inassra/PCB_TravailleurIsole/Présentation travailleur isolé.pptx.pdf

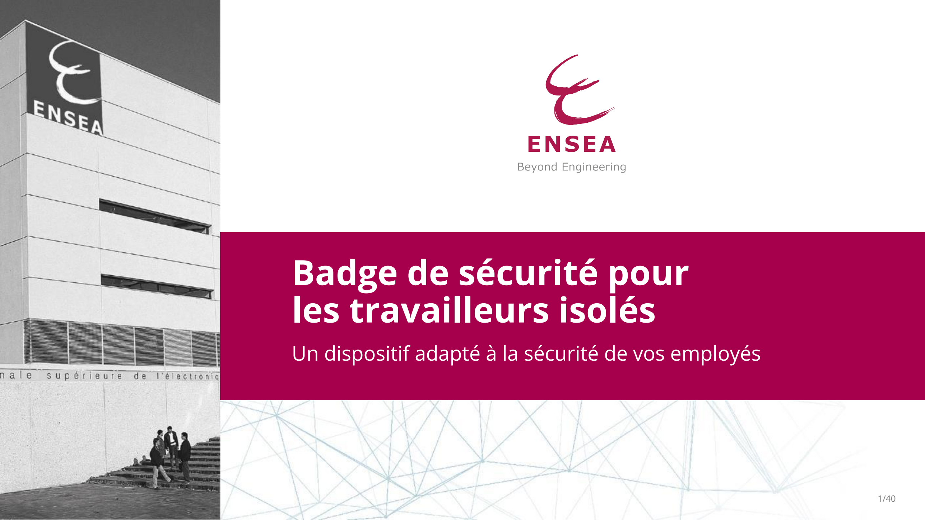
[picture p1: page 1]

# Badge de sécurité pour les travailleurs isolés

# Un dispositif adapté à la sécurité de vos employés

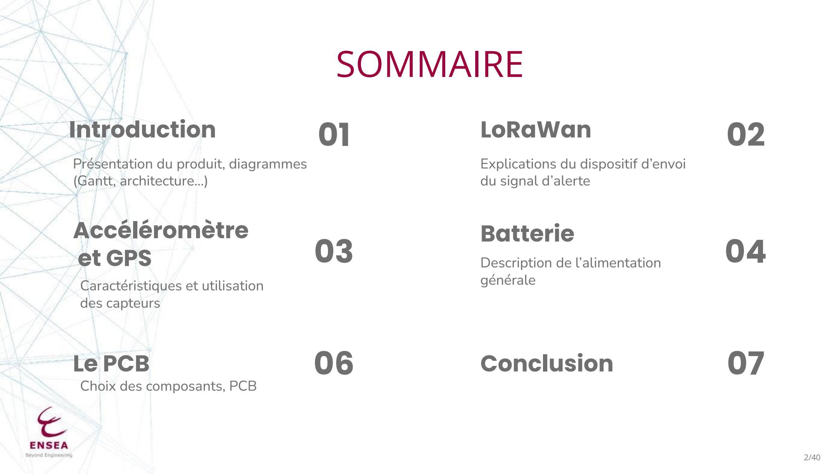
[picture p2: figure]
SOMMAIRE; Introduction; Présentation du produit, diagrammes (Gantt, architecture…); LoRaWan; Explications du dispositif d’envoi du signal d’alerte; Accéléromètre et GPS; Caractéristiques et utilisation des capteurs; Batterie; Description de l’alimentation générale; Le PCB; Choix des composants, PCB; Conclusion

# 01 Introduction

# Introduction 01

## ❖ En quoi consiste notre produit ?

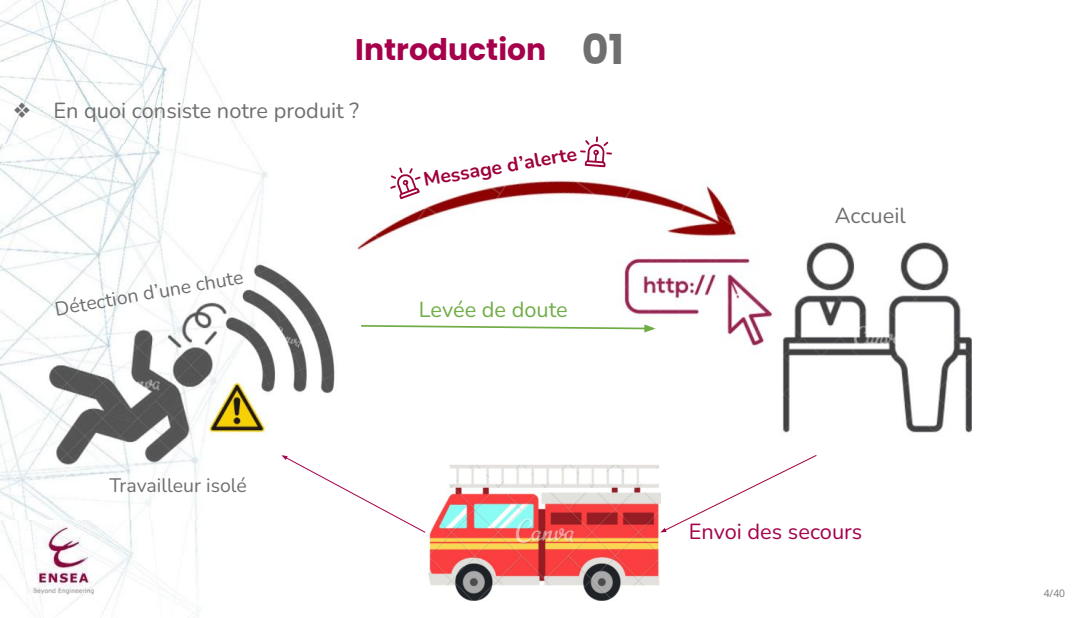
[picture p3: page 4]
Travailleur isolé; Accueil; Message d’alerte

Détection d’une chute

Levée de doute

Envoi des secours

# Introduction 01

## ❖ Le cahier des charges

Fonction | Sous-fonction | Critères | Niveaux
Localiser le travailleur (GPS) | | Précision | À 5 mètre près
| | Adapter au badge | Inférieur à feuille A5
| | Alimentation | 3,3V

Déterminer si le travailleur tombe
(Accéléromètre)
Mesurer l’accélération | Précision | 10 cm/s² mini suivant l’axe z
Mesurer la position | Précision | 5 cm mini suivant l’axe z

Détecter une pression sur

le bouton d’urgence | Durée pression | 3 s mini Bouton d’urgence

Détecter une pression sur
le bouton de fausse
urgence
| Alimentation | 3,3V
| Bonus « Haut parleur ou
LED» | 5/40

Fonction | Sous-fonction | Critères | Niveaux
Envoyer signal d’urgence (LoRaWan) | Envoyer signal à l’accueil Contenu Pas trop lourd (+ bonus « hôpital ») Localisation
Alimenter le système (Batterie) | | Autonomie | Entre 10h et 12h
| | Adapter au badge | Inférieur à feuille A5
| | Tension délivrée | 5V
| Se recharger | Temps de recharge | 3h mini
| | Doit résister à la recharge
Traitement de données (Carte STM32) | | Nombre d’entrées suffisantes
| | Recevoir les données
| | Envoyer signal au LoraWan | Si chute détectée

Rapidité

Alimentation | 5V

# Introduction 01

## ❖ Le cahier des charges

# Introduction 01

## ❖ Le diagramme d'architecture

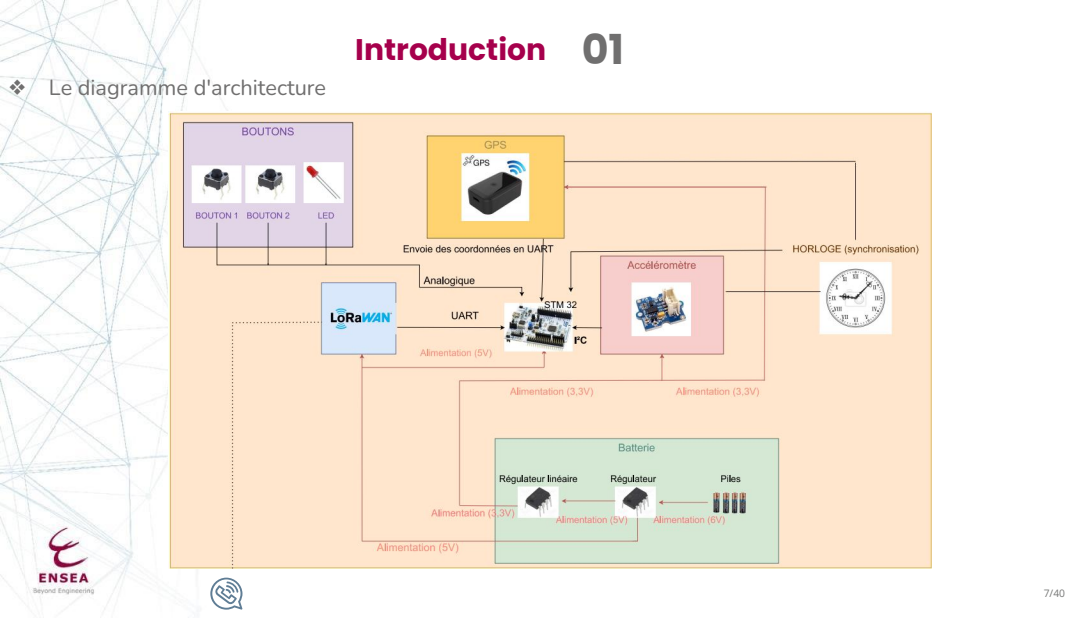
[picture p4: page 7]

# Introduction 01

## ❖ Le diagramme de Gantt

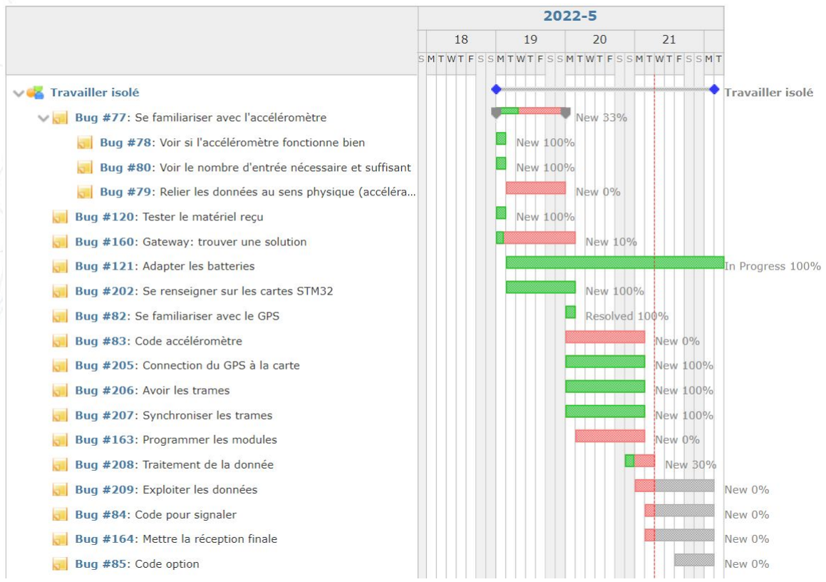
[picture p5: figure]

# 02 LoRaWan

## Qu’est-ce que LoRa ?

# LoRaWan 02

## ❖ LoRa ou LoRaWan ?

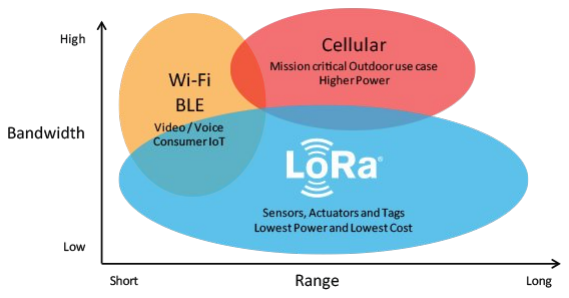
[picture p6: figure]
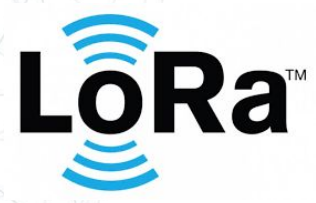
[picture p7: figure]

# LoRaWan 02

## ❖ LoRa ou LoRaWan ?

## Qu’est-ce que LoRaWAN ?

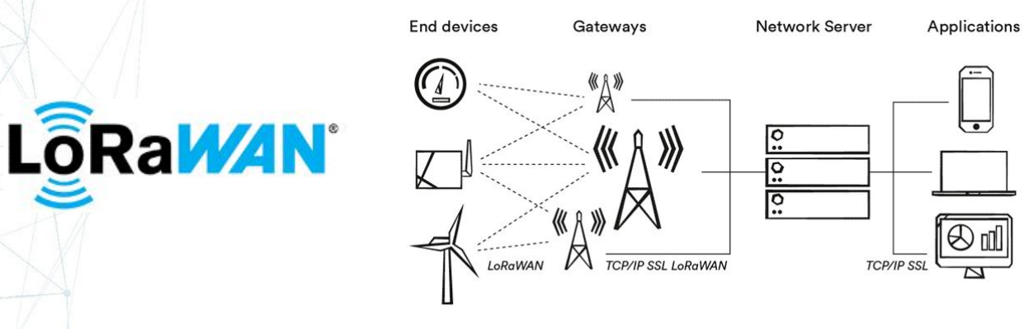
[picture p8: figure]

# LoRaWan 02

## ❖ Notre choix : pourquoi LoRa ?

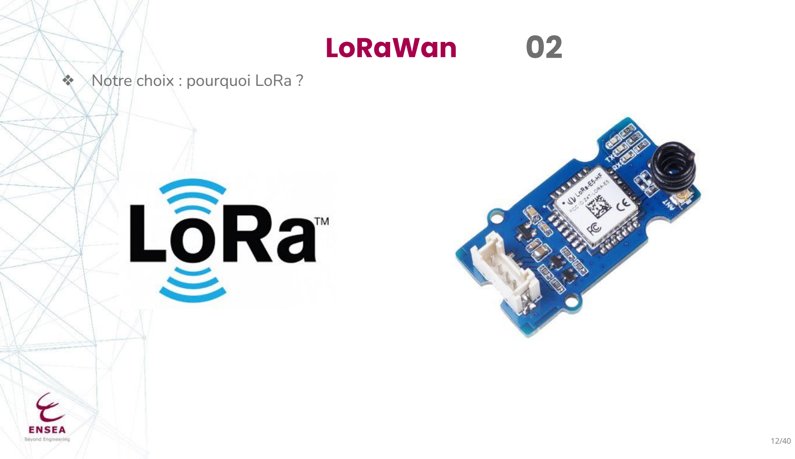
[picture p9: page 12]

# LoRaWan 02

## ❖ Le module

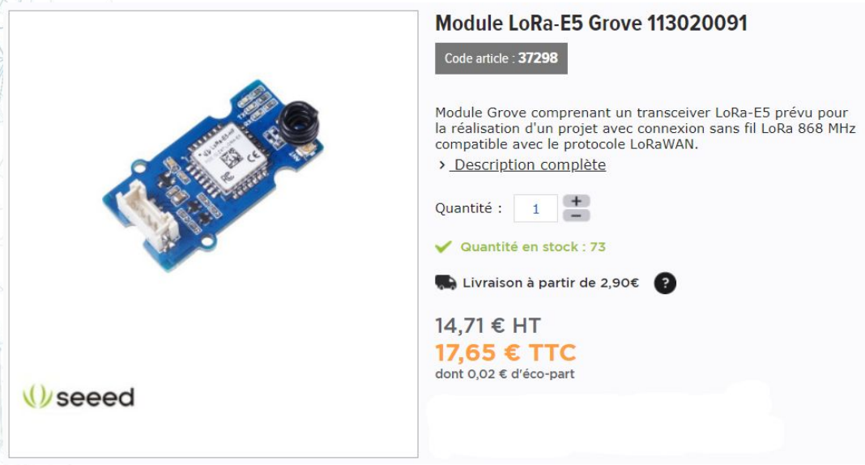
[picture p10: figure]

# LoRaWan 02

## ❖ Comment cela fonctionne-t-il ?

## P2P connection:

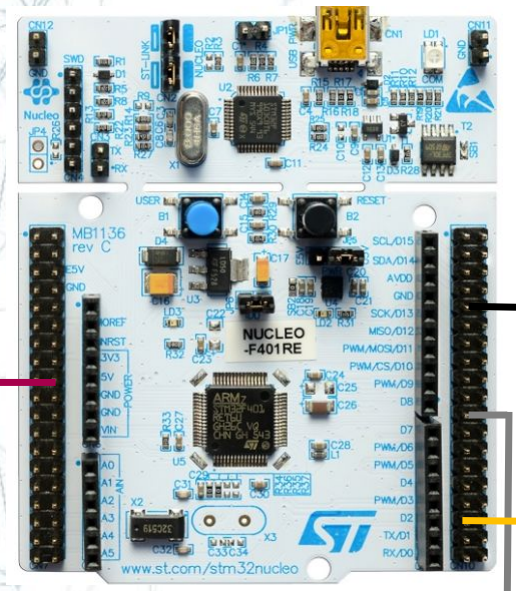
[picture p11: figure]
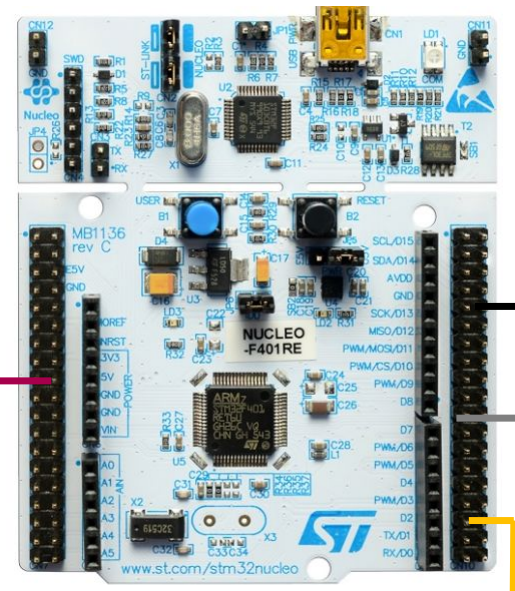
[picture p12: figure]

# LoRa

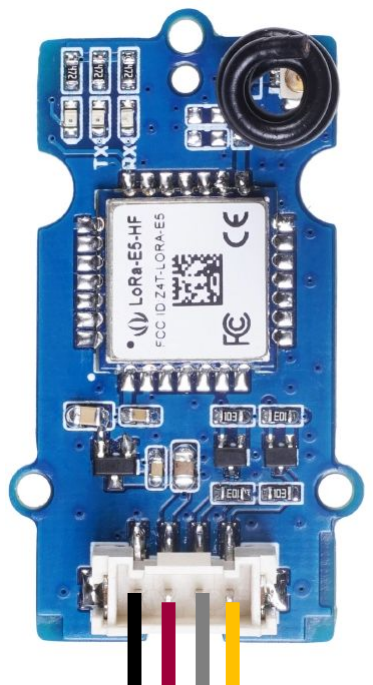
[picture p13: figure]
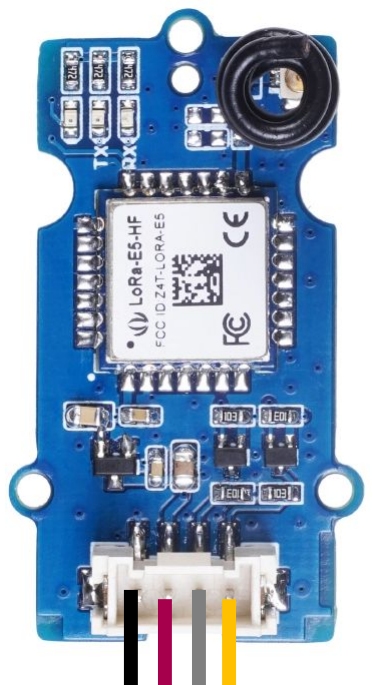
[picture p14: figure]

UART | UART

# LoRaWan 02

## ❖ Notre montage

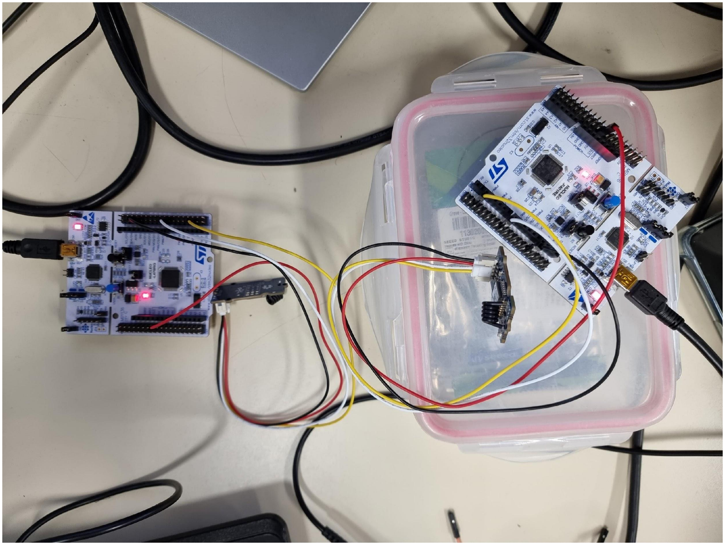
[picture p15: figure]

# 03 Accéléromètre et GPS

# Accéléromètre et GPS 03

## ❖ L’accéléromètre

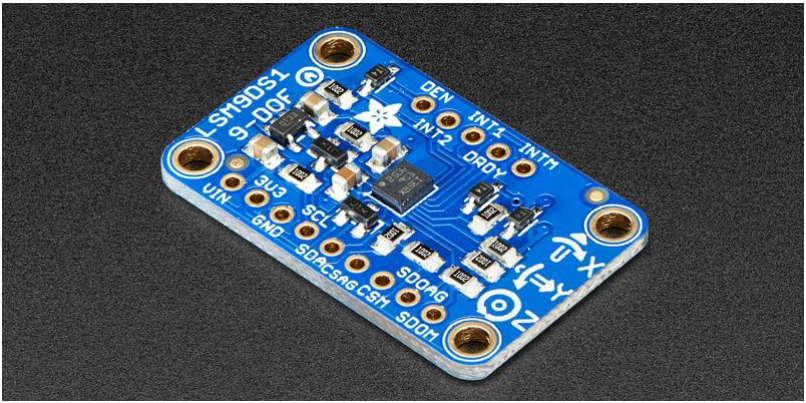
[picture p16: figure]

Adafruit LSM9DS1

# Accéléromètre et GPS 03

## ❖ L’accéléromètre : Analyse SWOT

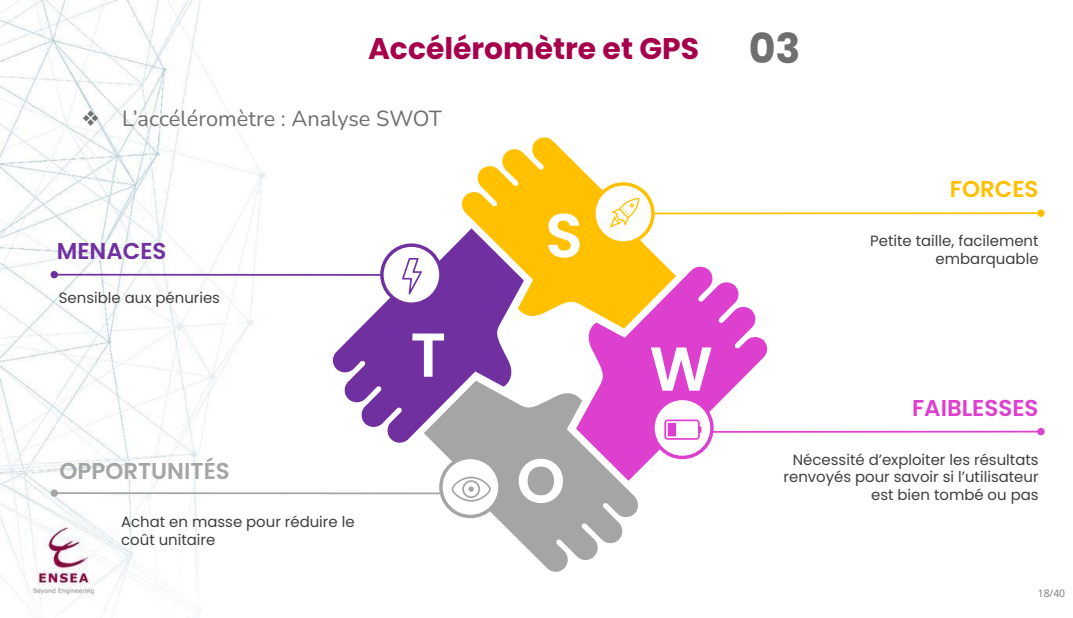
[picture p17: page 18]
embarquable; FORCES; FAIBLESSES; MENACES; OPPORTUNITÉS

Petite taille, facilement

Sensible aux pénuries

Nécessité d’exploiter les résultats
renvoyés pour savoir si l’utilisateur

est bien tombé ou pas

Achat en masse pour réduire le
coût unitaire

# Accéléromètre et GPS 03

## ❖ L’accéléromètre : le câblage

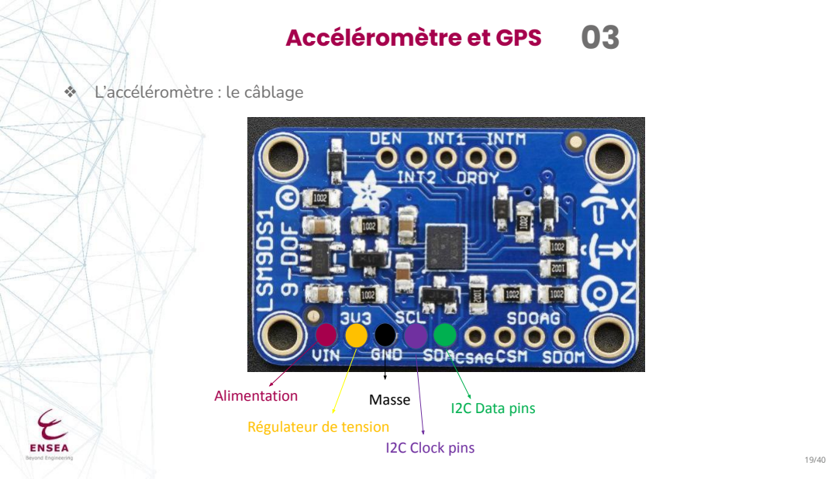
[picture p18: page 19]
Alimentation; Masse; I2C Clock pins; I2C Data pins

Régulateur de tension

# Accéléromètre et GPS 03

## ❖ L’accéléromètre : mode de fonctionnement

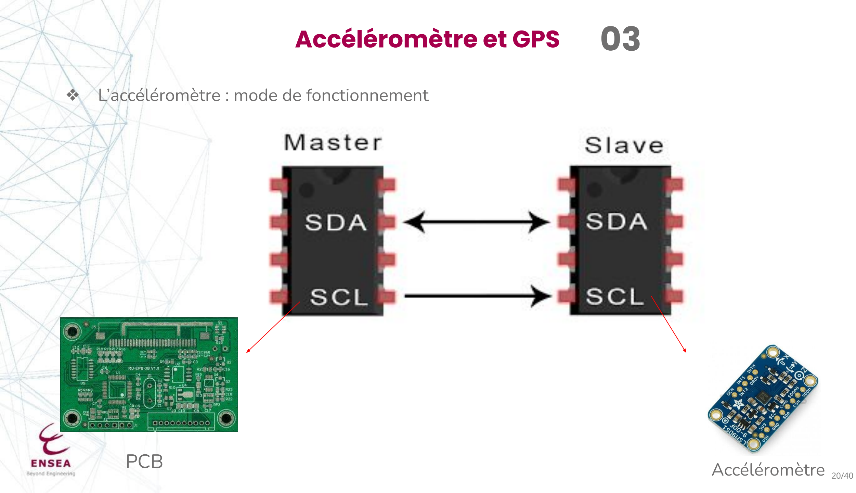
[picture p19: page 20]

PCB | Accéléromètre

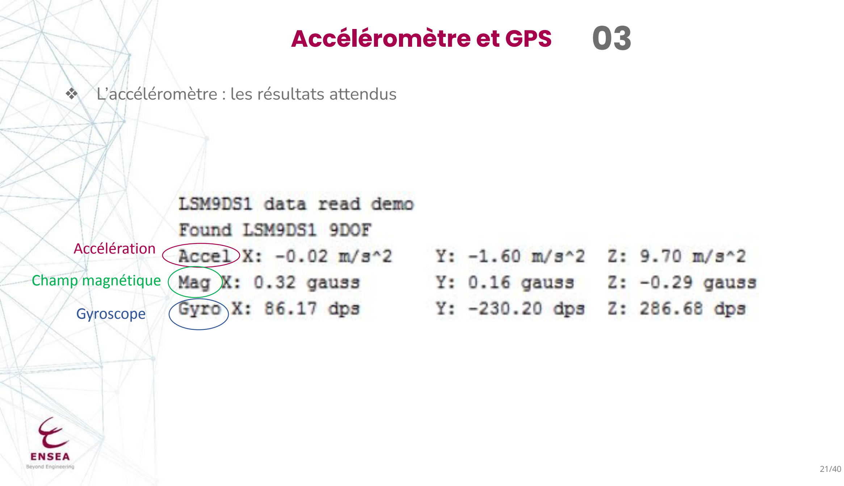
[picture p20: figure]
Accélération; Champ magnétique; Gyroscope; Accéléromètre et GPS

## ❖ L’accéléromètre : les résultats attendus

- Une alarme transmise par le LoraWan prévient un gardien que l’employé est tombé si Accel X >

## 10 cm/s

- Possibilité pour la personne de ne pas envoyer d’alerte si il est indemne via un bouton (si la

## deadline le permet)

- Possibilité de déclencher manuellement une alarme même sans chute si la personne ne se sent

## pas bien (si la deadline le permet)

# Accéléromètre et GPS 03

## ❖ L’accéléromètre : l’exploitation des données

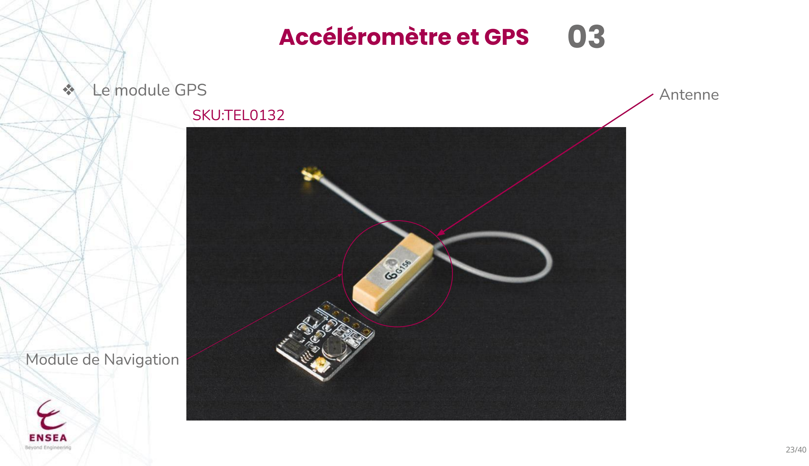
[picture p21: figure]
Accéléromètre et GPS; ❖ Le module GPS; Antenne; Module de Navigation; SKU:TEL0132

# Accéléromètre et GPS 03

## ❖ Le module GPS : l’analyse SWOT

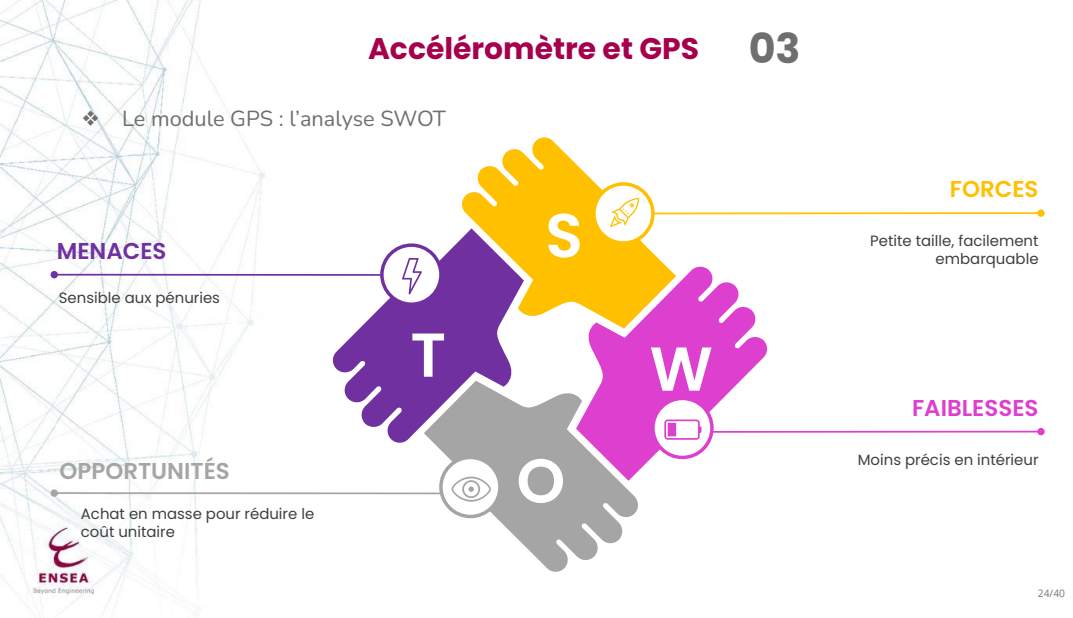
[picture p22: page 24]
embarquable; FORCES; FAIBLESSES; MENACES; OPPORTUNITÉS

Petite taille, facilement

Sensible aux pénuries

Moins précis en intérieur

Achat en masse pour réduire le
coût unitaire

# Accéléromètre et GPS 03

## ❖ Le module GPS : le câblage

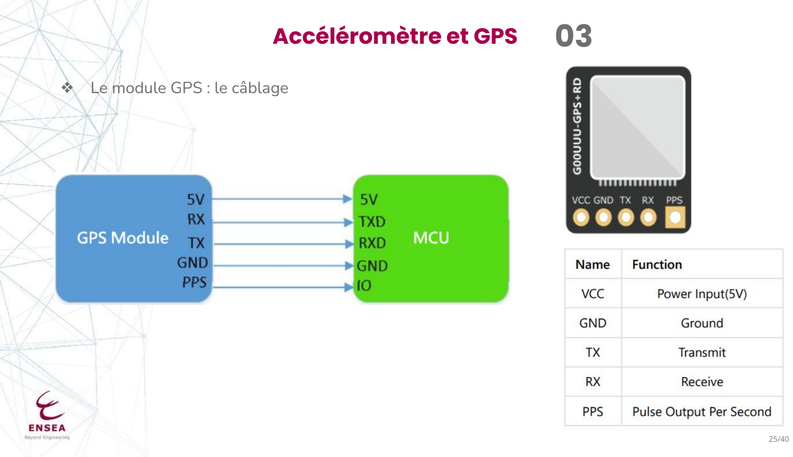
[picture p23: page 25]

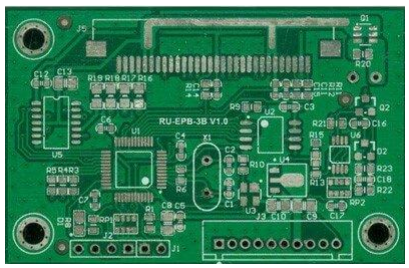
[picture p24: figure]

## PCB

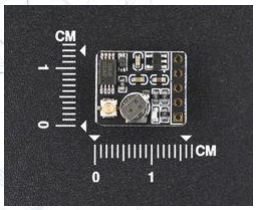
[picture p25: figure]

## Module GPS

# Accéléromètre et GPS 03

## ❖ Le module GPS : le fonctionnement

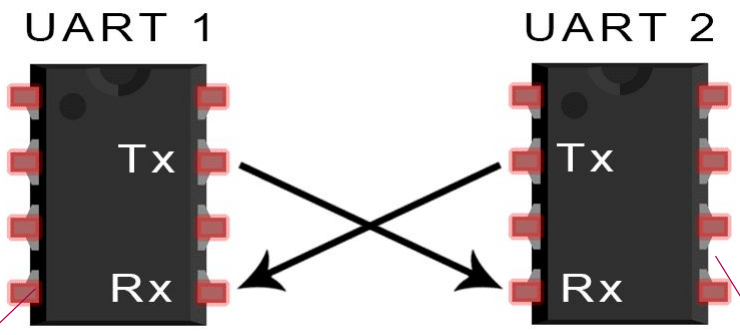
[picture p26: figure]

### ‘7’ : Nombre de satellites utilisés

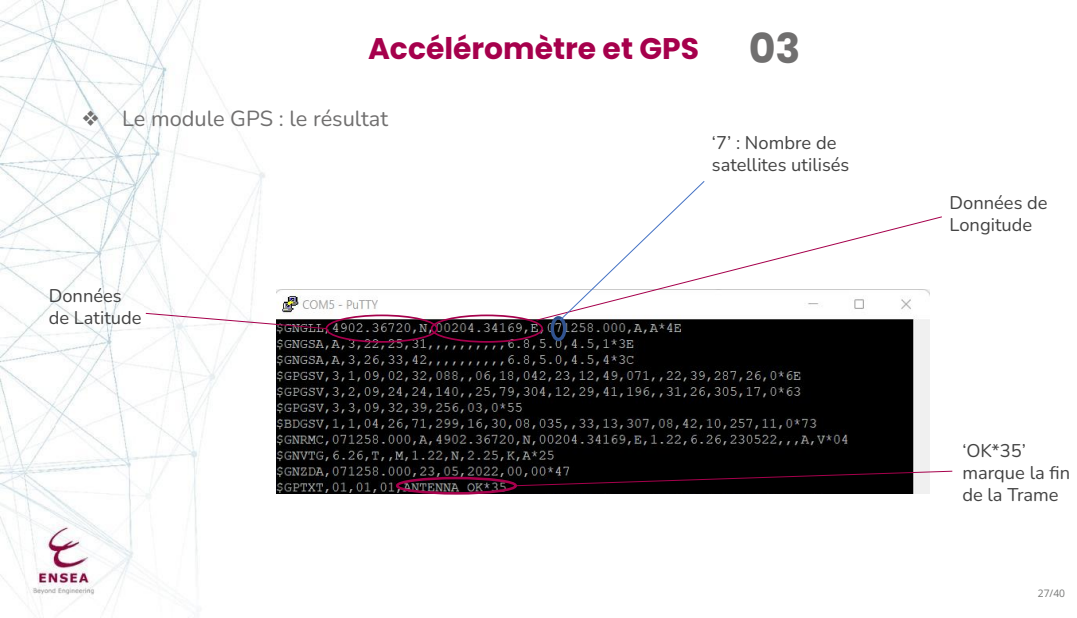
[picture p27: page 27]
Données de Latitude; Données de Longitude; Accéléromètre et GPS

❖ Le module GPS : le résultat

marque la fin
de la Trame

# Accéléromètre et GPS 03

## ❖ Le module GPS : traitement des données

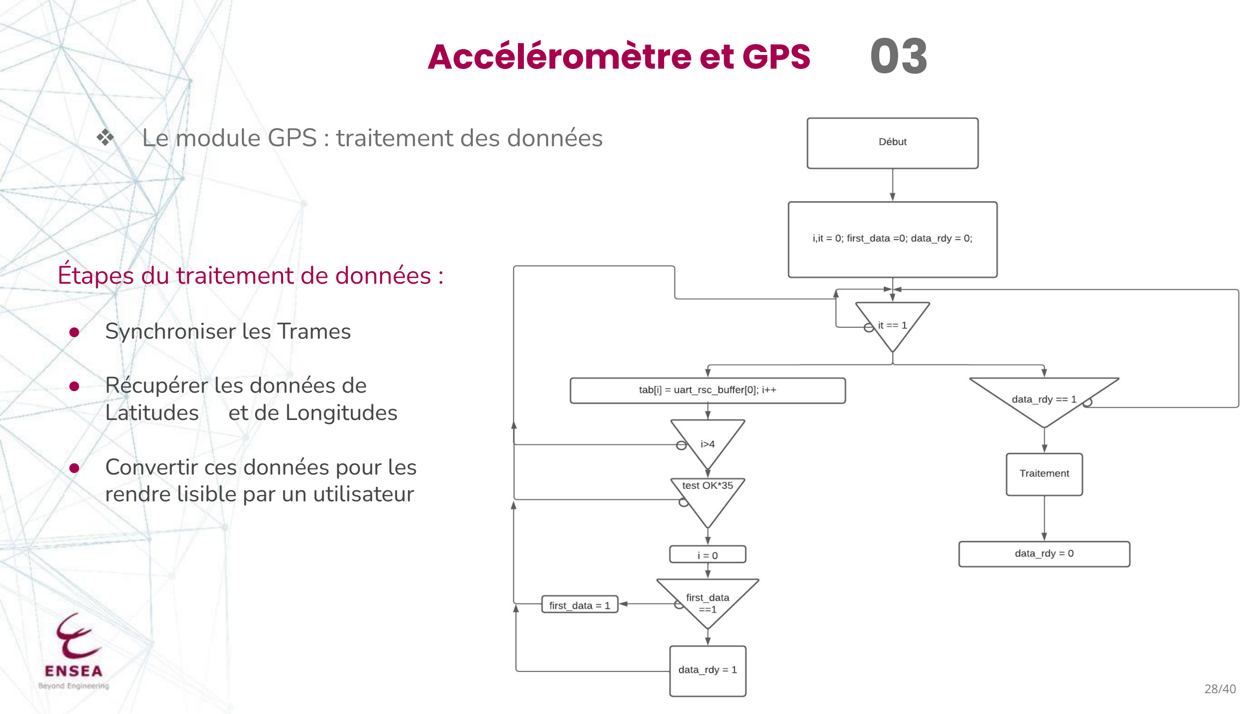
[picture p28: page 28]

## Étapes du traitement de données :

## - Synchroniser les Trames

## - Récupérer les données de Latitudes et de Longitudes

## - Convertir ces données pour les rendre lisible par un utilisateur

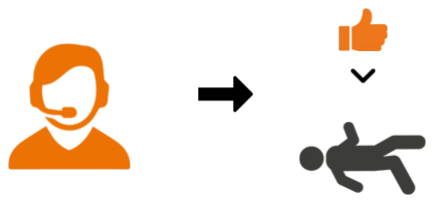
[picture p29: figure]

Le gardien reçoit grâce au LoraWan les coordonnées GPS de la personne qui a chuté.

# Accéléromètre et GPS 03

## ❖ Le module GPS : l’exploitation des données

# 04 La batterie

# La batterie 04

## ❖ Objectifs de l’alimentation

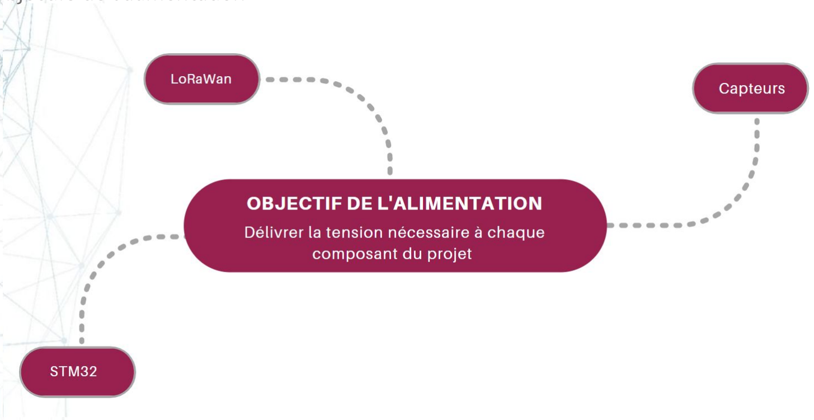
[picture p30: figure]

# La batterie 04

## ❖ Retour sur le cahier des charges

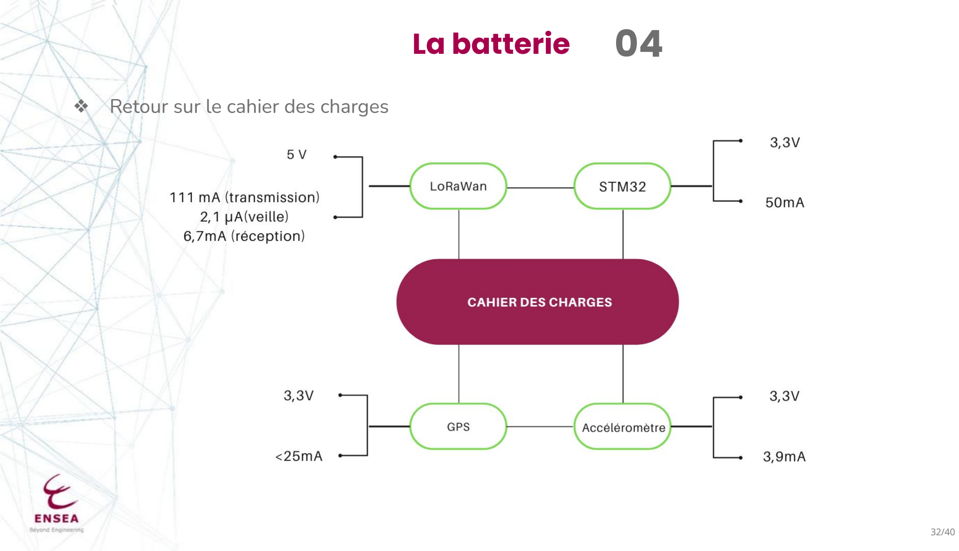
[picture p31: page 32]

# La batterie 04

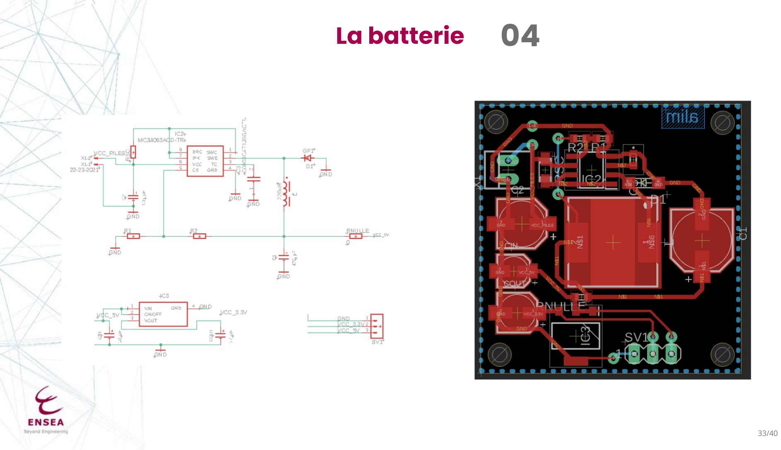
[picture p32: page 33]

# La batterie 04

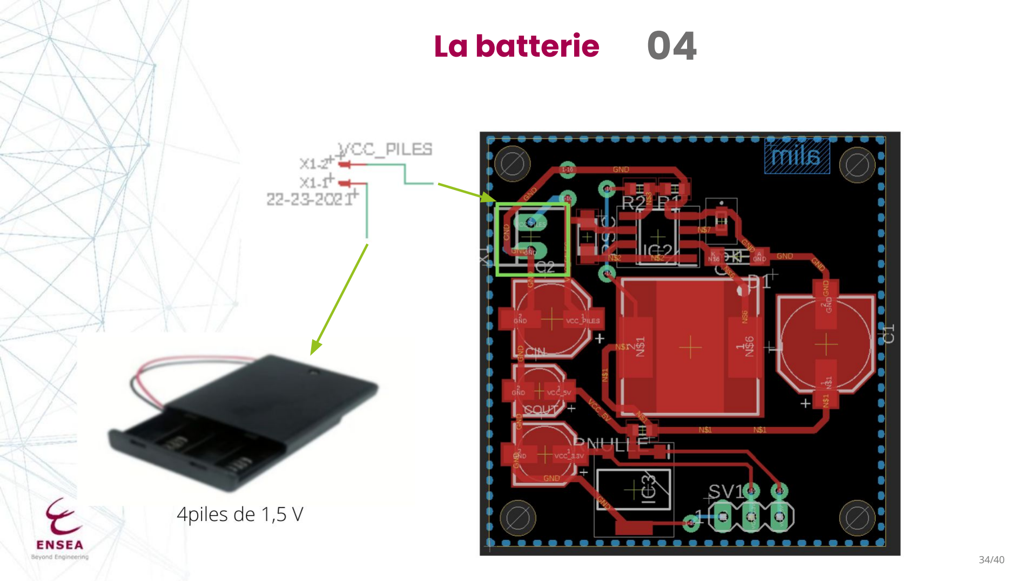
[picture p33: page 34]

# La batterie 04

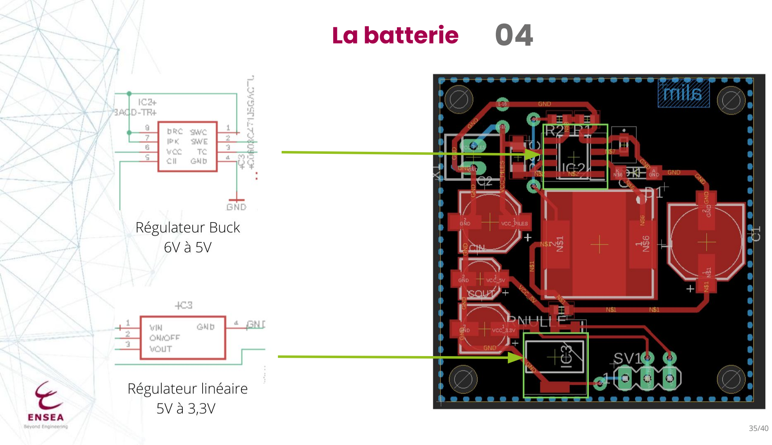
[picture p34: page 35]

# 05 Le PCB

# Le PCB 05

## ❖ Le PCB

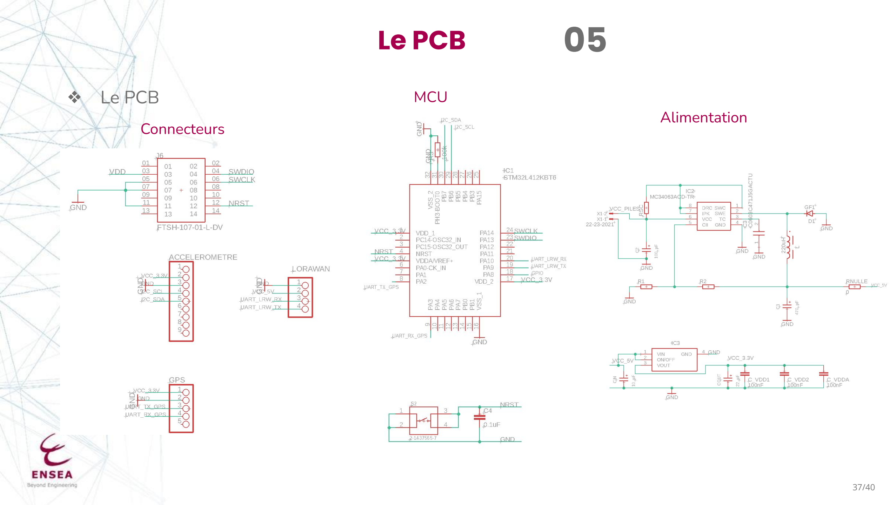
[picture p35: page 37]

### Connecteurs

### Alimentation

### MCU

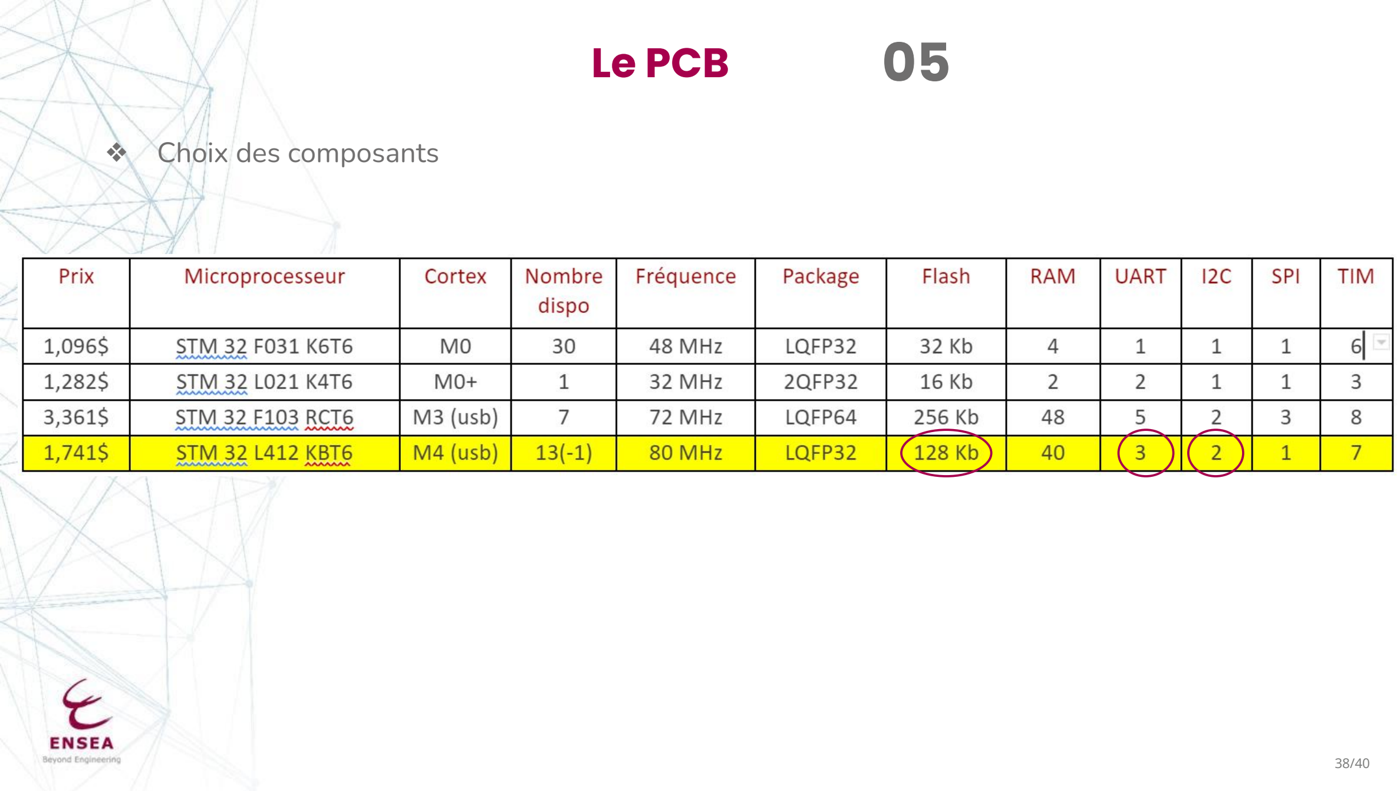
[picture p36: figure]
Le PCB; ❖ Choix des composants

# Le PCB 05

## ❖ Le coût total

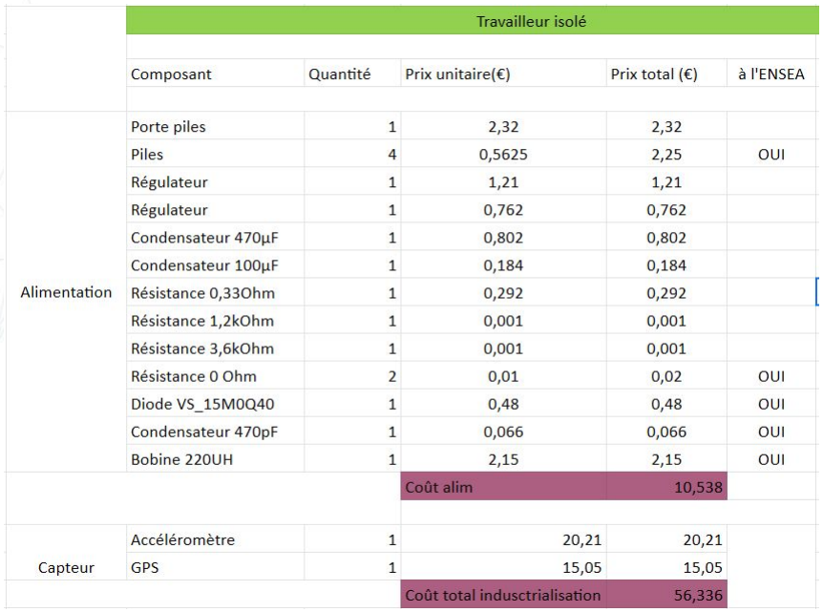
[picture p37: figure]

# 06 Conclusion
