inassra/PCB_TravailleurIsole/composants.xlsx

Composants | valeur | reference sur eagle
Rsc | 0,3 ohm | R-EU_R1206W
C1 | 470uF | telecharger sur wurth |  | 865060353009
C2 | 100uF | telecharger sur wurth |  | 865060445005
R1 | 1,2 kohm | R-EU_R0603
R2 | 3,6 kohm | R-EU_R0603
C3 | 470 pF | telecharger sur wurth |  | C0603C471J5GACTU | kemet | 264-4545 sur RS
L | 220 uH | telecharger sur wurth |  | 784771221
D1 | VS-15HQ040 | GF1 |  | foot print: DO 214
Cin | 10 uF | telecharger sur wurth |  | 865060440001
Cout | 22 uF | telecharger sur wurth |  | 865060442002
resistance nulle
 |  | Travailleur isolé
 |  | Composant | Quantité | Prix unitaire(€) | Prix total (€) | à l'ENSEA
Alimentation | Alimentation | Porte piles | 1 | 2.32 | 2.32
 |  | Piles | 4 | 0.5625 | 2.25 | OUI
 |  | Régulateur | 1 | 1.21 | 1.21
 |  | Régulateur | 1 | 0.762 | 0.762
 |  | Condensateur 470µF | 1 | 0.802 | 0.802
 |  | Condensateur 100µF | 1 | 0.184 | 0.184
 |  | Résistance 0,33Ohm | 1 | 0.292 | 0.292
 |  | Résistance 1,2kOhm | 1 | 0.001 | 0.001
 |  | Résistance 3,6kOhm | 1 | 0.001 | 0.001
 |  | Résistance 0 Ohm | 2 | 0.01 | 0.02 | OUI
 |  | Diode VS_15M0Q40 | 1 | 0.48 | 0.48 | OUI
 |  | Condensateur 470pF | 1 | 0.066 | 0.066 | OUI
 |  | Bobine 220UH | 1 | 2.15 | 2.15 | OUI
Capteur |  |  |  | Coût alim | 10.538
 | Capteur | Accéléromètre | 1 | 20.21 | 20.21
 |  | GPS | 1 | 15.05 | 15.05
 |  |  |  | Coût total indusctrialisation | 56.336
 |  | Compost connecté
 |  | Composant | Quantité | Prix unitaire(€) | Prix total (€) | à l'ENSEA
Alimentation
 | Alimentation | Batterie | 1 | 5.46 | 5.46 | OUI
 |  | Régulateur | 1 | 1.21 | 1.21
 |  | Régulateur | 1 | 0.762 | 0.762
 |  | Condensateur 470µF | 1 | 0.802 | 0.802
 |  | Condensateur 100µF | 1 | 0.184 | 0.184
 |  | Résistance 0,33Ohm | 1 | 0.292 | 0.292
 |  | Résistance 1,2kOhm | 1 | 0.001 | 0.001
 |  | Résistance 3,6kOhm | 1 | 0.001 | 0.001
 |  | Résistance 0 Ohm | 2 | 0.01 | 0.02 | OUI
 |  | Diode VS_15M0Q40 | 1 | 0.48 | 0.48 | OUI
 |  | Condensateur 470pF | 1 | 0.066 | 0.066 | OUI
Capteurs |  | Bobine 220UH | 1 | 2.15 | 2.15 | OUI
 |  |  |  | Coût alim | 11.428
 | Capteurs | Capteur humidité | 1 | 11.26 | 11.26
 |  | Capteur PH | 1 | 32.3 | 32.3 | OUI
 |  | Capteur température | 1 | 0.42 | 0.42 | OUI
 |  |  |  | Coût total indusctrialisation | 66.836
 |  | Badge alzeihmer
 |  | Composant | Quantité | Prix unitaire(€) | Prix total (€) | à l'ENSEA
 | Alimentation | Porte piles | 1 | 2.32 | 2.32
 |  | Piles | 4 | 0.5625 | 2.25 | OUI
 |  | Régulateur | 1 | 1.21 | 1.21
 |  | Régulateur | 1 | 0.762 | 0.762
 |  | Condensateur 470µF | 1 | 0.802 | 0.802
 |  | Condensateur 100µF | 1 | 0.184 | 0.184
 |  | Résistance 0,33Ohm | 1 | 0.292 | 0.292
 |  | Résistance 1,2kOhm | 1 | 0.001 | 0.001
 |  | Résistance 3,6kOhm | 1 | 0.001 | 0.001
 |  | Résistance 0 Ohm | 2 | 0.01 | 0.02 | OUI
 |  | Diode VS_15M0Q40 | 1 | 0.48 | 0.48 | OUI
 |  | Condensateur 470pF | 1 | 0.066 | 0.066 | OUI
 |  | Bobine 220UH | 1 | 2.15 | 2.15 | OUI
 |  |  |  | Coût alim | 10.538
 | Capteurs | GPS | 1 | 15.05 | 15.05
 |  |  |  | Coût total indusctrialisation | 36.126
