inassra/PCB_TravailleurIsole/pcb_all.brd

## EAGLE design pcb_all.brd (2022-06-01)

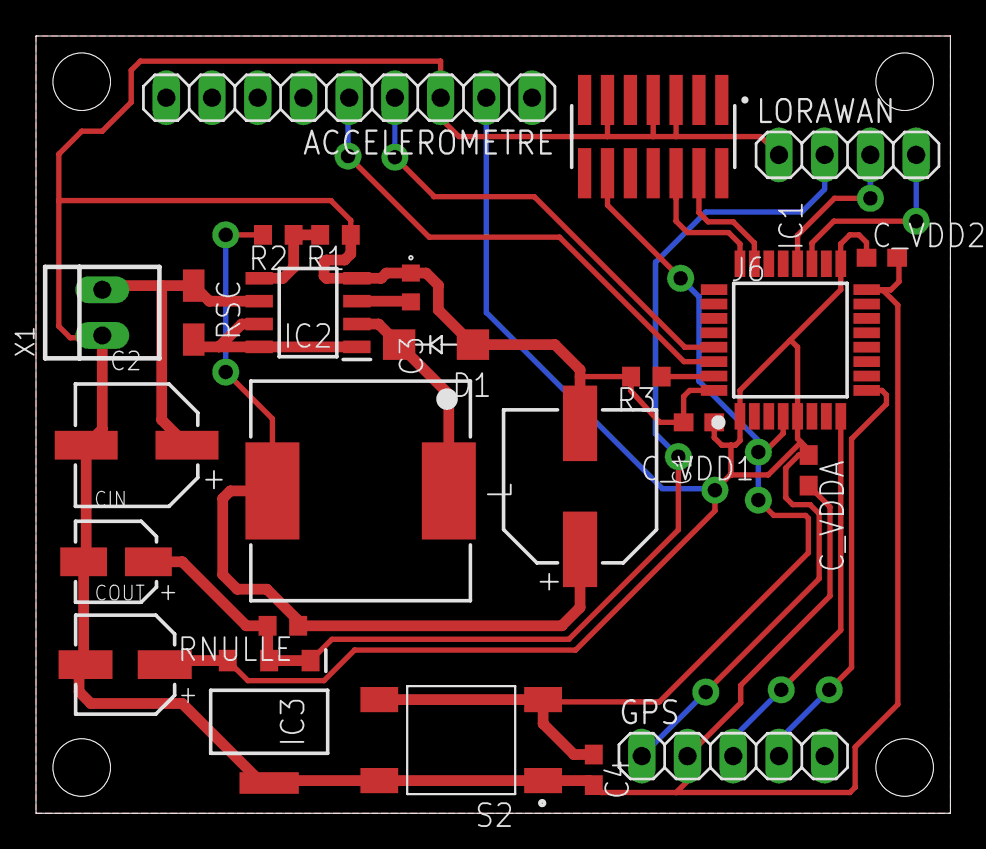
[picture p38: board pcb_all.brd from above]

Board: 2 copper layers, 50.8 x 43.2 mm, 25 parts (0 on the bottom side), 19 nets.

Parts:
ACCELEROMETRE: 1X09
C1: 470 µF; WCAP-ASLL_8X10.5(DXL)
C2: 100 µF; WCAP-ASLL_6.3X7.7(DXL)
C3: C0603C471J5GACTU; C0603
C4: 0.1uF; C0603
CIN: 10 µF; WCAP-ASLL_4X5.5(DXL)
COUT: 22 µF; WCAP-ASLL_5X5.5(DXL)
C_VDD1, C_VDD2: 100nF; C0603
C_VDDA: 100nF; C0603
D1: GF1; SMA-DO214AC
GPS: 1X05
IC1: STM32L412KBT6; QFP80P900X900X160-32N
IC2: MC34063ACD-TR; SOIC127P600X175-8N
IC3: NCV33375ST3.3T3G; SOT230P700X175-4N
J6: FTSH-107-01-L-DV; SAMTEC_FTSH-107-01-L-DV
L: 220uH; WE-PDA_1260
LORAWAN: 1X04
R1, R2: R0603
R3: 100k; R0603
RNULLE: 0; R0603
RSC: R1206W
S2: 2-1437565-7; SW_2-1437565-7
X1: 22-23-2021

Connections:
GND: ACCELEROMETRE.3, C1.2, C2.2, C3.1, C4.2, CIN.2, COUT.2, C_VDD1.2, C_VDD2.2, C_VDDA.2, D1.A, GPS.2, IC1.16, IC1.32, IC2.4, IC3.4, J6.05, J6.07, J6.11, LORAWAN.1, R1.1, R3.2, S2.1, S2.2, X1.1
I2C_SCL: ACCELEROMETRE.4, IC1.29
I2C_SDA: ACCELEROMETRE.5, IC1.30
unnamed: C1.1, L.2, R2.2, RNULLE.1
unnamed: IC2.1, IC2.7, IC2.8, RSC.2
unnamed: IC2.5, R1.2, R2.1
unnamed: IC1.31, R3.1
unnamed: D1.K, IC2.2, L.1
unnamed: C3.2, IC2.3
NRST: C4.1, IC1.4, J6.12, S2.3, S2.4
SWCLK: IC1.24, J6.06
SWDIO: IC1.23, J6.04
UART_LRW_RX: IC1.20, LORAWAN.3
UART_LRW_TX: IC1.19, LORAWAN.4
UART_RX_GPS: GPS.4, IC1.9
UART_TX_GPS: GPS.3, IC1.8
VCC_3.3V: ACCELEROMETRE.2, COUT.1, C_VDD1.1, C_VDD2.1, C_VDDA.1, GPS.1, IC1.1, IC1.5, IC1.17, IC3.3
VCC_5V: CIN.1, IC3.1, IC3.2, LORAWAN.2, RNULLE.2
VCC_PILES: C2.1, IC2.6, RSC.1, X1.2
