inassra/PCB_TravailleurIsole/(commit log)

2022-06-01 Rename pcb_all (1).brd to pcb_all.brd
    [pcb_all.brd]
2022-06-01 Rename pcb_all (1).sch to pcb_all.sch
    [pcb_all.sch]
2022-06-01 Create principe de batterie
