inassra/PCB_TravailleurIsole/(notices)

Notices in the files:
parts and their libraries:
C1: Copyright: Würth Elektronik
